mprosk/wow_and_flutter/README.md

# Wow & Flutter
Wow &amp; Flutter is a pitch modulation source designed to emulate the nostalgic warbles of a aged tape deck.

Output is selectable between triangle or random sample and hold with slew. A jumper on the back of the module sets three different output levels
