mprosk/wow_and_flutter/schematic.pdf

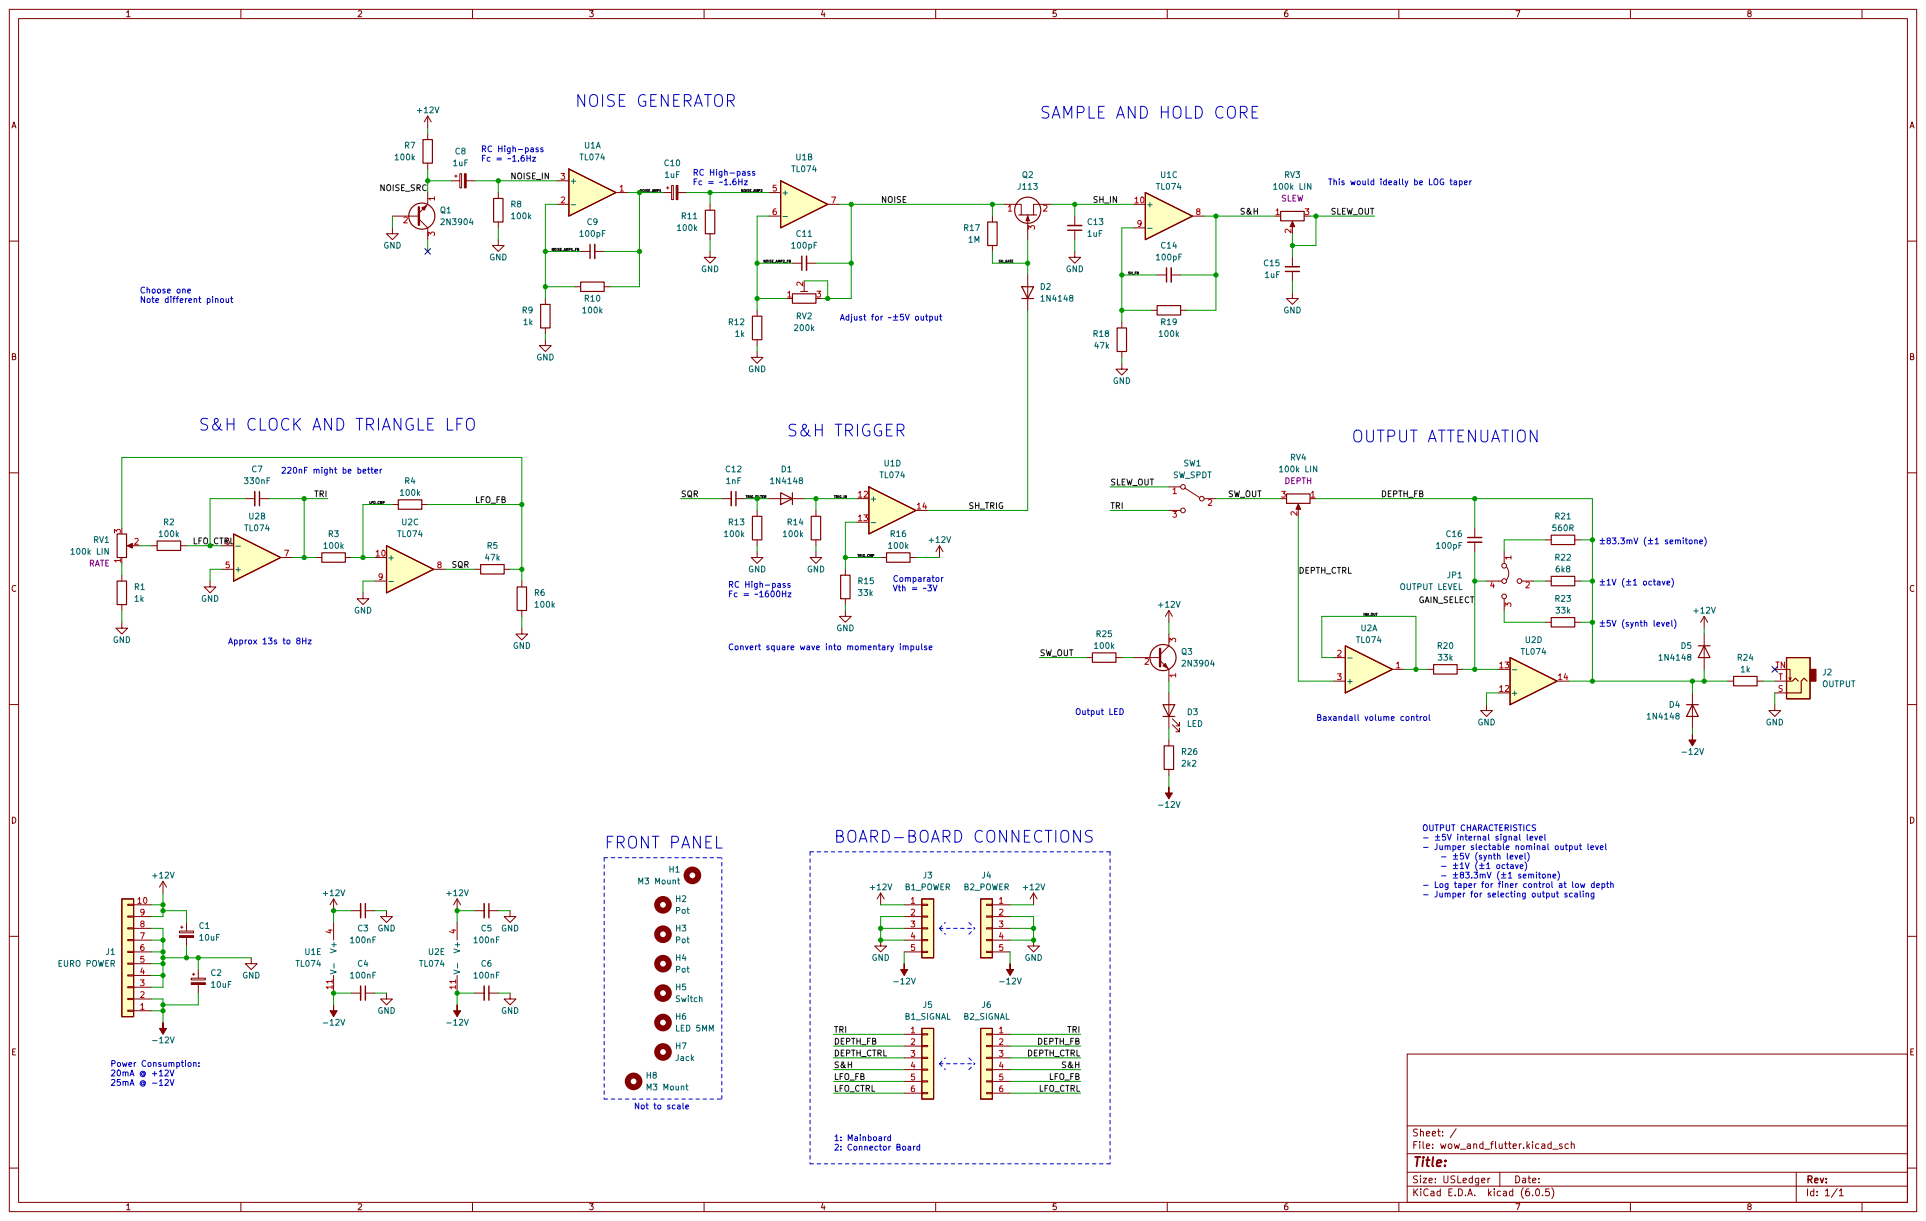
[picture p1: page 1]

This would ideally be LOG taper

Baxandall volume control 220nF might be better Choose one Note different pinout

OUTPUT ATTENUATION S&H CLOCK AND TRIANGLE LFO

- Jumper slectable nominal output level
- Log taper for finer control at low depth
- Jumper for selecting output scaling
