mprosk/wow_and_flutter/sim/s&h.asc

B1: bv; V=10*white(20e3*time)
C1: cap; 0.1µ
C2: cap; 0.1µ
C3: cap; 0.1µ
C4: cap; 0.1µ
C5: cap; 1µ
D1: diode
J1: njf
R1: res; 1Meg
R2: res; 390k
R3: res; 390k
R4: res; 390k
R5: res; 1k
U1: UniversalOpAmp2
V1: voltage; 12
V2: voltage; -12
V3: voltage; PULSE(-12 12 0 0.001 .001 0 .1)
V4: voltage; SINE(0 5 0.5)
Named nets: 0, NOISE, V+, V-, SH_OUT, SH_TRIG, OUT, SH_FILT, SINE
.tran 2
