mprosk/wow_and_flutter/sim/lfo_tri.asc

C1: cap; 10n
R1: res; 100k
R2: res; 100k
R3: res; 100k
R4: res; 4.7k
R5: res; 10k
R6: res; 0
R7: res; 100k
U1: UniversalOpAmp2
U2: UniversalOpAmp2
V1: voltage; 12
V2: voltage; -12
Named nets: 0, V+, V-, TRI, SQR
.tran 1 uic
.meas tran T1 find time when V(sqr)=0 rise 2
.meas tran T2 find time when V(sqr)=0 rise 3
.meas tran Frequency param 1/(T2-T1)
