mprosk/wow_and_flutter/wow_and_flutter/wow_and_flutter.kicad_pcb

## KiCad design wow_and_flutter/wow_and_flutter.kicad_pcb (2023-02-15)

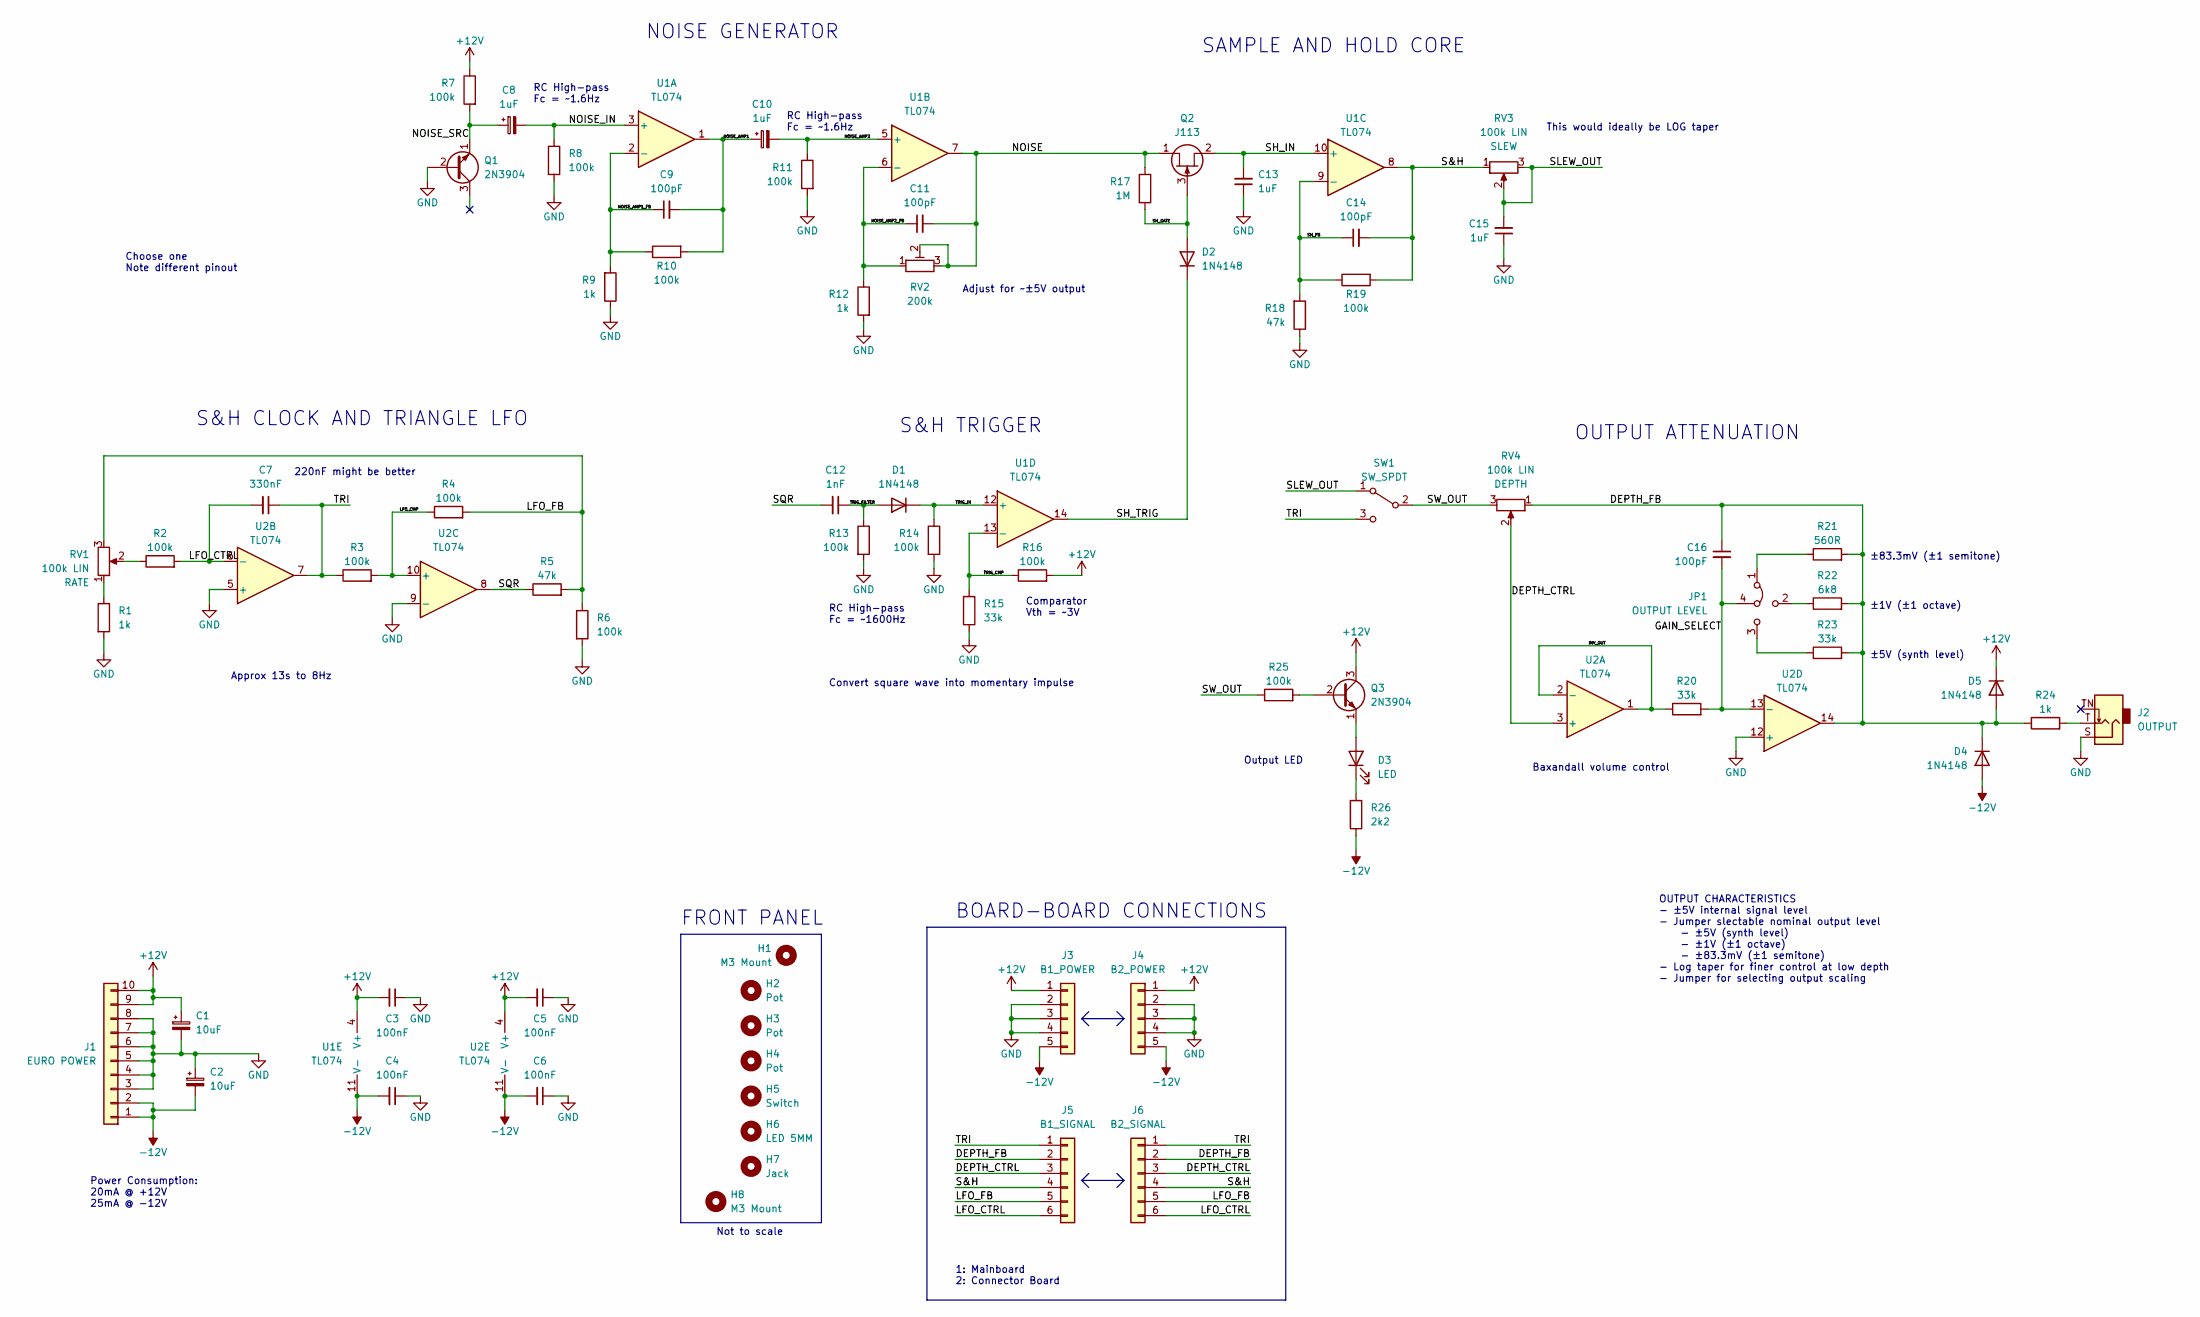
[picture p2: schematic wow_and_flutter.kicad_sch]

Parts:
C1, C2: 10uF; CP_Radial_D4.0mm_P1.50mm
C3, C4, C5, C6: 100nF; C_Disc_D3.0mm_W1.6mm_P2.50mm
C7: 330nF; C_Disc_D3.0mm_W1.6mm_P2.50mm
C8, C10: 1uF; CP_Radial_D4.0mm_P1.50mm
C9, C11, C14, C16: 100pF; C_Disc_D3.0mm_W1.6mm_P2.50mm
C12: 1nF; C_Disc_D3.0mm_W1.6mm_P2.50mm
C13, C15: 1uF; C_Disc_D3.0mm_W1.6mm_P2.50mm
D1, D2, D4, D5: 1N4148; D_DO-34_SOD68_P7.62mm_Horizontal
D3: LED; LED_D5.0mm
H1, H8: M3 Mount; MountingHole_3.2mm_M3
H2, H3, H4: Pot; Hole_Pot
H5: Switch; Hole_Toggle_Switch
H6: LED 5MM; Hole_LED_5mm
H7: Jack; Hole_Jack_3.5mm
J1: EURO POWER; IDC-Header_2x05_P2.54mm_Vertical
J2: OUTPUT; Jack_3.5mm_QingPu_WQP-PJ301BM
J3: B1_POWER; PinHeader_1x05_P2.54mm_Vertical
J4: B2_POWER; PinSocket_1x05_P2.54mm_Vertical
J5: B1_SIGNAL; PinHeader_1x06_P2.54mm_Vertical
J6: B2_SIGNAL; PinSocket_1x06_P2.54mm_Vertical
JP1: OUTPUT LEVEL; Jumper_3_to_1
Q1, Q3: 2N3904; TO-92_Inline
Q2: J113; TO-92_Inline
R1, R9, R12, R24: 1k; R_Axial_DIN0207_L6.3mm_D2.5mm_P10.16mm_Horizontal
R2, R3, R4, R6, R7, R8, R10, R11, R13, R14, R16, R19, R25: 100k; R_Axial_DIN0207_L6.3mm_D2.5mm_P10.16mm_Horizontal
R5, R18: 47k; R_Axial_DIN0207_L6.3mm_D2.5mm_P10.16mm_Horizontal
R15, R20, R23: 33k; R_Axial_DIN0207_L6.3mm_D2.5mm_P10.16mm_Horizontal
R17: 1M; R_Axial_DIN0207_L6.3mm_D2.5mm_P10.16mm_Horizontal
R21: 560R; R_Axial_DIN0207_L6.3mm_D2.5mm_P10.16mm_Horizontal
R22: 6k8; R_Axial_DIN0207_L6.3mm_D2.5mm_P10.16mm_Horizontal
R26: 2k2; R_Axial_DIN0207_L6.3mm_D2.5mm_P10.16mm_Horizontal
RV1, RV3, RV4: 100k LIN; Potentiometer_TT_P0915N
RV2: 200k; Potentiometer_Trim_Horizontal
SW1: SW_SPDT; Switch_SPDT
U1, U2: TL074; DIP-14_W7.62mm

Connections:
+12V: C1.1, C3.2, C5.2, D5.1 (K), J1.9, J1.10, J3.1, J4.1, Q3.3 (C), R7.1, R16.2, U1.4 (V+), U2.4 (V+)
-12V: C2.2, C4.2, C6.2, D4.2 (A), J1.1, J1.2, J3.5, J4.5, R26.1, U1.11 (V-), U2.11 (V-)
/DEPTH_CTRL: J5.3, J6.3, RV4.2, U2.3 (+)
/DEPTH_FB: C16.1, D4.1 (K), D5.2 (A), J5.2, J6.2, R21.2, R22.2, R23.2, R24.1, RV4.1, U2.14
/GAIN_SELECT: C16.2, JP1.4 (C), R20.2, U2.13 (-)
/INV_OUT: R20.1, U2.1, U2.2 (-)
/LFO_CMP: R3.2, R4.1, U2.10 (+)
/LFO_CTRL: C7.2, J5.6, J6.6, R2.2, U2.6 (-)
/LFO_FB: J5.5, J6.5, R4.2, R5.2, R6.1, RV1.3
/NOISE: C11.2, Q2.1 (D), R17.1, RV2.2, RV2.3, U1.7
/NOISE_AMP1: C9.2, C10.1, R10.2, U1.1
/NOISE_AMP1_FB: C9.1, R9.2, R10.1, U1.2 (-)
/NOISE_AMP2: C10.2, R11.1, U1.5 (+)
/NOISE_AMP2_FB: C11.1, R12.1, RV2.1, U1.6 (-)
/NOISE_IN: C8.2, R8.1, U1.3 (+)
/NOISE_SRC: C8.1, Q1.1 (E), R7.2
/S&H: C14.2, J5.4, J6.4, R19.2, RV3.1, U1.8
/SH_FB: C14.1, R18.2, R19.1, U1.9 (-)
/SH_GATE: D2.2 (A), Q2.3 (G), R17.2
/SH_IN: C13.2, Q2.2 (S), U1.10 (+)
/SH_TRIG: D2.1 (K), U1.14
/SLEW_OUT: C15.2, RV3.2, RV3.3, SW1.1 (A)
/SQR: C12.2, R5.1, U2.8
/SW_OUT: R25.1, RV4.3, SW1.2 (B)
/TRI: C7.1, J5.1, J6.1, R3.1, SW1.3 (C), U2.7
/TRIG_CMP: R15.2, R16.1, U1.13 (-)
/TRIG_FILTER: C12.1, D1.2 (A), R13.1
/TRIG_IN: D1.1 (K), R14.1, U1.12 (+)
GND: C1.2, C2.1, C3.1, C4.1, C5.1, C6.1, C13.1, C15.1, J1.3, J1.4, J1.5, J1.6, J1.7, J1.8, J2.S, J3.2, J3.3, J3.4, J4.2, J4.3, J4.4, Q1.2 (B), R1.2, R6.2, R8.2, R9.1, R11.2, R12.2, R13.2, R14.2, R15.1, R18.1, U2.5 (+), U2.9 (-), U2.12 (+)
unnamed: D3.1 (K), R26.2
unnamed: D3.2 (A), Q3.1 (E)
unnamed: J2.T, R24.2
unnamed: JP1.1 (A), R21.1
unnamed: JP1.2 (C), R22.1
unnamed: JP1.3 (B), R23.1
unnamed: Q3.2 (B), R25.2
unnamed: R1.1, RV1.1
unnamed: R2.1, RV1.2

Notes on the sheet:
Power Consumption: 20mA @ +12V 25mA @ -12V
OUTPUT CHARACTERISTICS - ±5V internal signal level - Jumper slectable nominal output level - ±5V (synth level) - ±1V (±1 octave) - ±83.3mV (±1 semitone) - Log taper for finer control at low depth - Jumper for selecting output scaling
Not to scale
This would ideally be LOG taper
Choose one Note different pinout
±5V (synth level)
NOISE GENERATOR
RC High-pass Fc = ~1.6Hz
Approx 13s to 8Hz
Output LED
RC High-pass Fc = ~1600Hz
±83.3mV (±1 semitone)
S&H TRIGGER
Convert square wave into momentary impulse
1: Mainboard 2: Connector Board
220nF might be better
±1V (±1 octave)
OUTPUT ATTENUATION
Adjust for ~±5V output
Baxandall volume control
FRONT PANEL
BOARD-BOARD CONNECTIONS
S&H CLOCK AND TRIANGLE LFO
Comparator Vth = ~3V
SAMPLE AND HOLD CORE

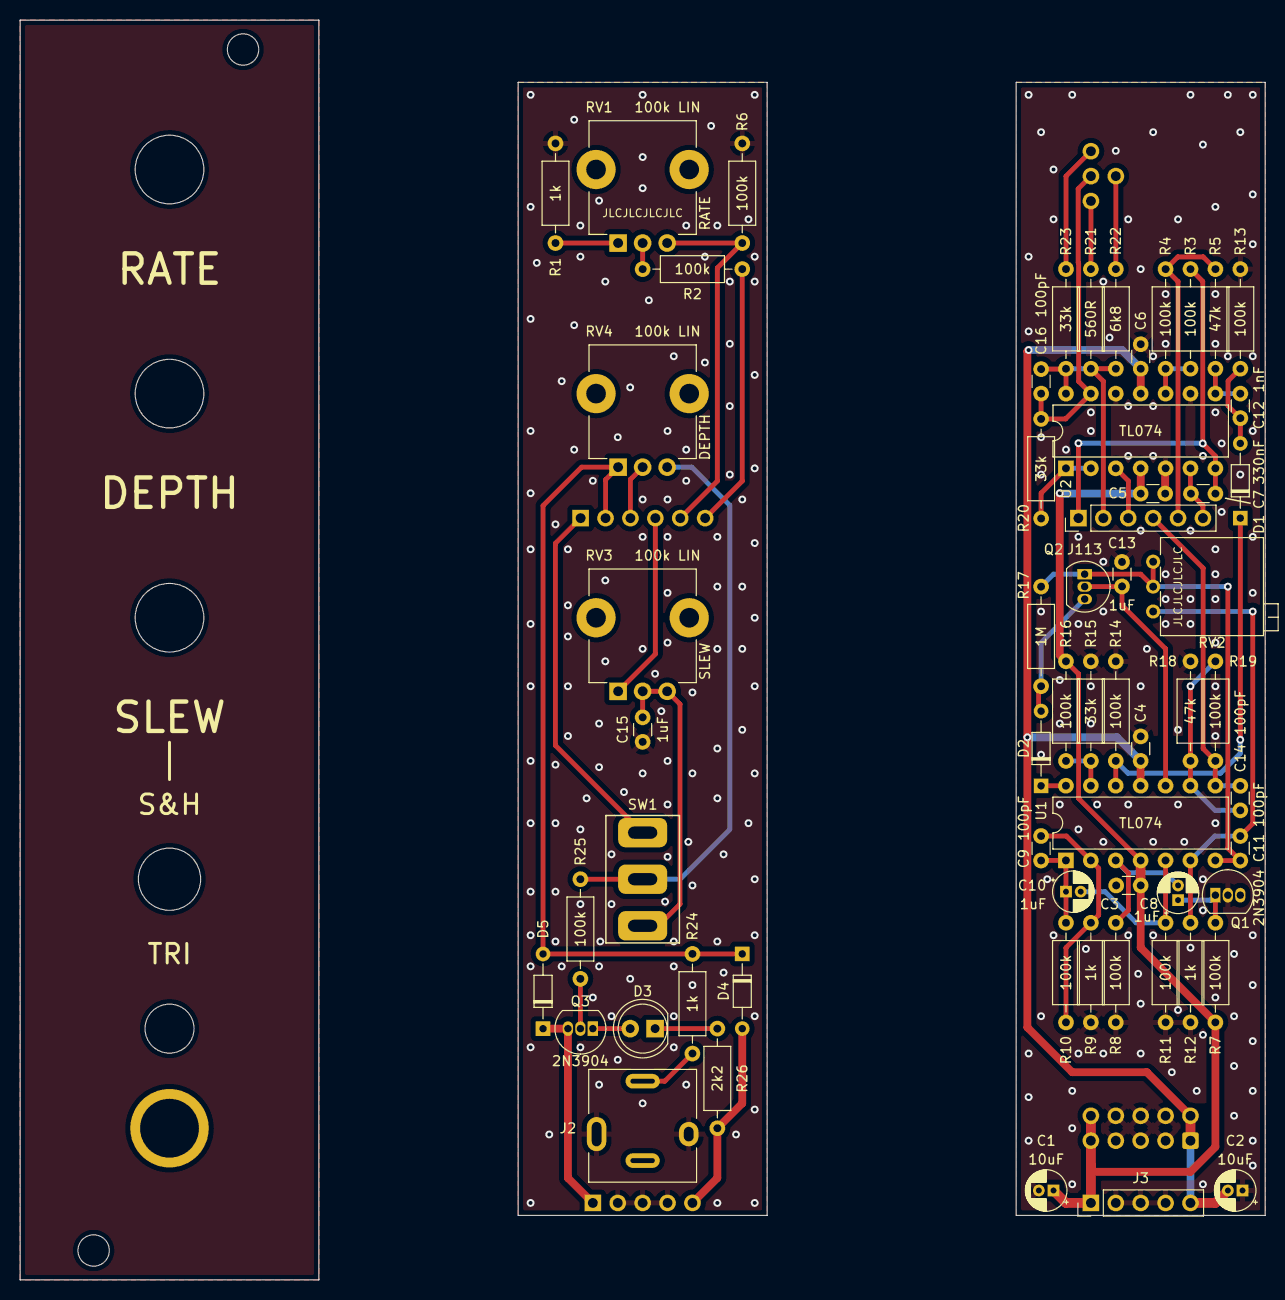
[picture p3: board wow_and_flutter.kicad_pcb from above]

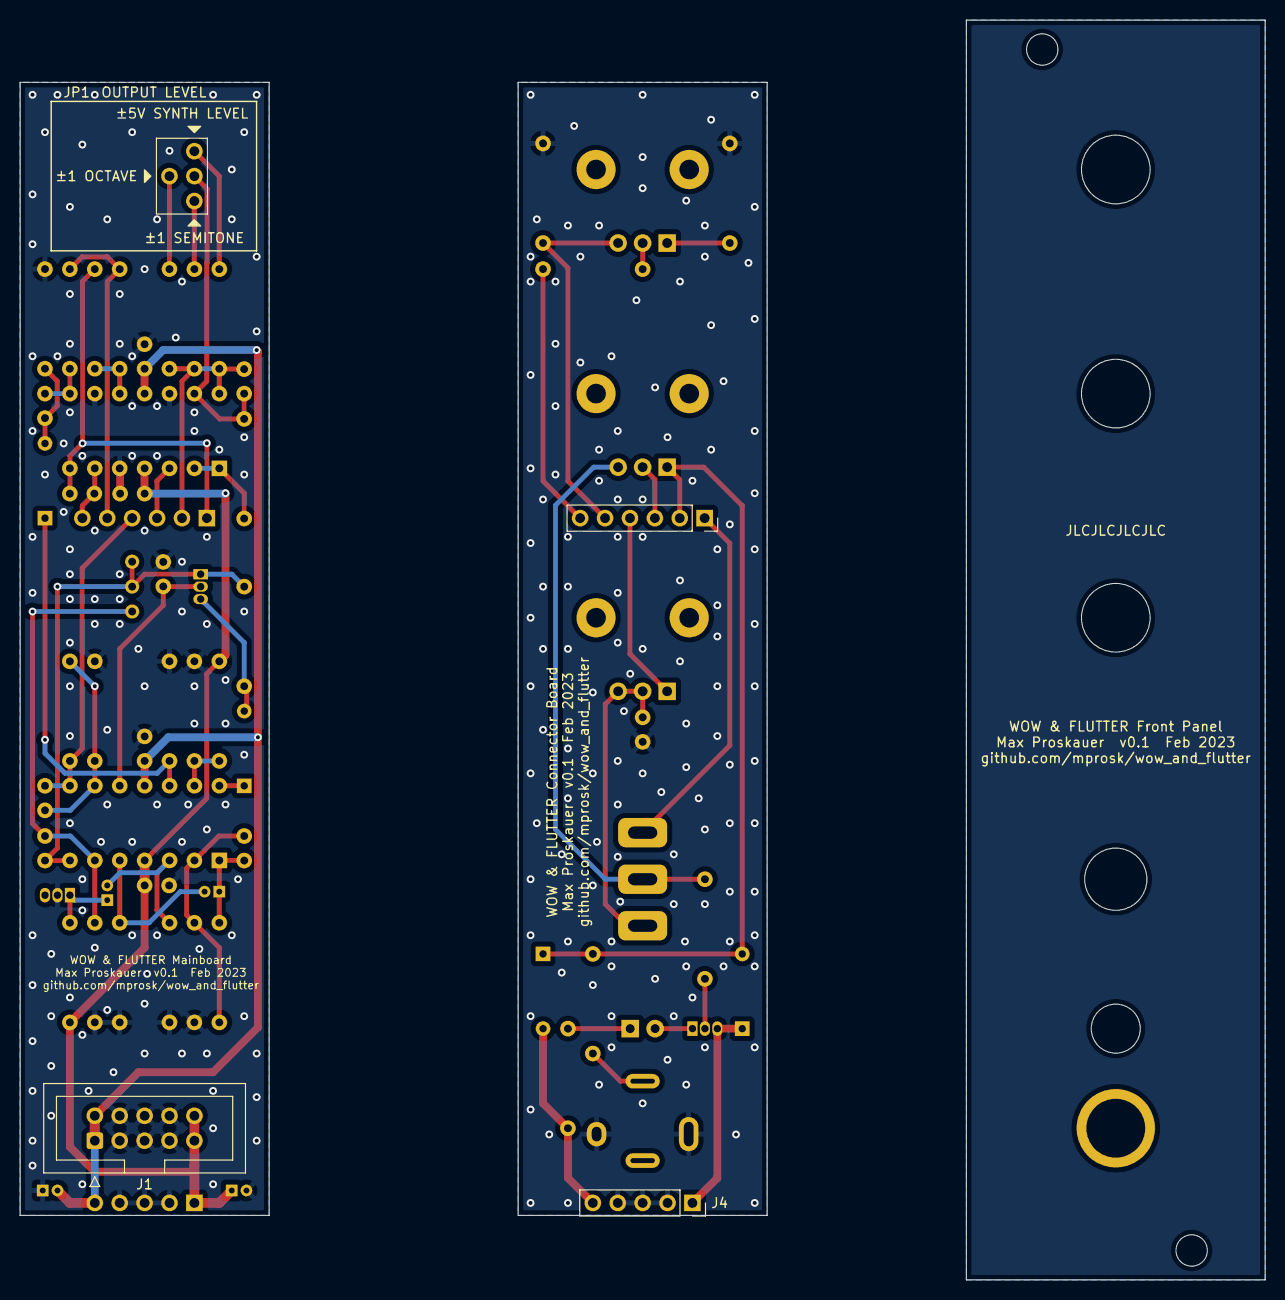
[picture p4: board wow_and_flutter.kicad_pcb from below]

Board: 2 copper layers, 127.0 x 128.5 mm, 72 parts (4 on the bottom side), 38 nets.
