mprosk/wow_and_flutter/(threads)

Thread 1 (2023-10-12):

3U?

SjoerdDraaisma, 2023-10-12:
Although the Panel is eurorack (3U) size, the PCBs behind it are too large to fit a rack like that
