mprosk/wow_and_flutter/(commit log)

2023-02-15 Complete PCB laout
    [wow_and_flutter-B_Cu.gbr, wow_and_flutter-B_Mask.gbr, wow_and_flutter-B_Silkscreen.gbr, wow_and_flutter-Edge_Cuts.gbr, wow_and_flutter-F_Cu.gbr, wow_and_flutter-F_Mask.gbr, wow_and_flutter-F_Silkscreen.gbr, wow_and_flutter-NPTH.drl]
2023-02-15 Add version info to PCBs
    [wow_and_flutter-B_Cu.gbr, wow_and_flutter-B_Mask.gbr, wow_and_flutter-B_Silkscreen.gbr, wow_and_flutter-Edge_Cuts.gbr, wow_and_flutter-F_Cu.gbr, wow_and_flutter-F_Mask.gbr, wow_and_flutter-F_Silkscreen.gbr, wow_and_flutter-NPTH.drl]
2023-12-20 Add list of issues on schematic
    [wow_and_flutter.kicad_sch]
